koe1234/pentagon_2_666_le/(list of files, cad)

Other CAD files:
LE/PAE_MCU/utils/rom2c/Unit.obj
LE/PAE_MCU/utils/rom2c/compress.obj
