koe1234/pentagon_2_666_le/LE/PAE_MCU/make.txt

1. Скопировать образы ROM ZX-Spectrum и программы fatall в .\rom
2. Запустить все bat-файлы (если не надо менять прошивку rom/fpga, то соответствующий bat не запускать)
3. Открыть проект в keil uvision, выполнить "rebuild all target files"
4. Полученный pae_mcu.hex зашивать в контроллер.
