koe1234/pentagon_2_666_le/(threads)

Thread 1 (2024-10-18):

2.666 FE

NS-Clone, 2024-10-18:
Для моих аморальных проджоктов надо 100500 метров рамы
И пентевых хватит всем маловато будет
``2x8 Mb`` это 16мбит или 16 метров?
как ими рулить?
будет алоно 16с + банкоматная пол литра?

koe1234, 2024-10-21:
----------------
                        18.10.2024, 23:24, "NS-Clone" ***@***.***>:
                        Кому: koe1234/pentagon_2_666_le ***@***.***);
                        Копия: Subscribed ***@***.***);
                        Тема: [koe1234/pentagon_2_666_le] 2.666 FE (Issue #1);
                        16 метров. И с 16 битной шиной данных. 16с и вся банкоматная графика уже есть.
               
Для моих аморальных проджоктов надо 100500 метров рамы
И пентевых хватит всем маловато будет
2x8 Mb это 16мбит или 16 метров?
как ими рулить?
будет алоно 16с + банкоматная пол литра?

—Reply to this email directly, view it on GitHub, or unsubscribe.You are receiving this because you are subscribed to this thread.Message ID: ***@***.***>

NS-Clone, 2024-10-21:
> 16 метров.

ну тогда нада порты
они придуманы ужо?
16 метрами через один порт не порулишь
это или 2 порта на окно
возможно с защелкой старшего адреса
или же 2 бита нада вешать на адрес
и тогда можно будет щелкать сразу за один out
