koe1234/pentagon_2_666_le/LE/PAE_MCU/Firmwarez/usb/usbcfg.h

/*----------------------------------------------------------------------------
 *      U S B  -  K e r n e l
 *----------------------------------------------------------------------------
 *      Name:    USBCFG.H
 *      Purpose: USB Custom Configuration
 *      Version: V1.10
 *----------------------------------------------------------------------------
 *      This software is supplied "AS IS" without any warranties, express,
 *      implied or statutory, including but not limited to the implied
 *      warranties of fitness for purpose, satisfactory quality and
 *      noninfringement. Keil extends you a royalty-free right to reproduce
 *      and distribute executable files created using this software for use
 *      on Philips LPC microcontroller devices only. Nothing else gives you
 *      the right to use this software.
 *
 *      Copyright (c) 2005-2006 Keil Software.
 *---------------------------------------------------------------------------*/

#ifndef __USBCFG_H__
#define __USBCFG_H__

//*** <<< Use Configuration Wizard in Context Menu >>> ***

/*
// <h> USB Configuration
//   <o0> USB Power
//        <i> Default Power Setting
//        <0=> Bus-powered
//        <1=> Self-powered
//   <o1> Vendor ID <0x0000-0xFFFF>
//   <o2> Product ID <0x0000-0xFFFF>
//   <o3> Max Number of Interfaces <1-256>
//   <o4> Max Number of Endpoints  <1-32>
//   <o5> Max Endpoint 0 Packet Size
//        <8=> 8 Bytes <16=> 16 Bytes <32=> 32 Bytes <64=> 64 Bytes
//   <e6> DMA Transfer
//     <i> Use DMA for selected Endpoints
//     <o7.0>  Endpoint 0 Out
//     <o7.1>  Endpoint 0 In
//     <o7.2>  Endpoint 1 Out
//     <o7.3>  Endpoint 1 In
//     <o7.4>  Endpoint 2 Out
//     <o7.5>  Endpoint 2 In
//     <o7.6>  Endpoint 3 Out
//     <o7.7>  Endpoint 3 In
//     <o7.8>  Endpoint 4 Out
//     <o7.9>  Endpoint 4 In
//     <o7.10> Endpoint 5 Out
//     <o7.11> Endpoint 5 In
//     <o7.12> Endpoint 6 Out
//     <o7.13> Endpoint 6 In
//     <o7.14> Endpoint 7 Out
//     <o7.15> Endpoint 7 In
//     <o7.16> Endpoint 8 Out
//     <o7.17> Endpoint 8 In
//     <o7.18> Endpoint 9 Out
//     <o7.19> Endpoint 9 In
//     <o7.20> Endpoint 10 Out
//     <o7.21> Endpoint 10 In
//     <o7.22> Endpoint 11 Out
//     <o7.23> Endpoint 11 In
//     <o7.24> Endpoint 12 Out
//     <o7.25> Endpoint 12 In
//     <o7.26> Endpoint 13 Out
//     <o7.27> Endpoint 13 In
//     <o7.28> Endpoint 14 Out
//     <o7.29> Endpoint 14 In
//     <o7.30> Endpoint 15 Out
//     <o7.31> Endpoint 15 In
//   </e>
// </h>
*/

#define USB_POWER           1
#define USB_HID_VID         0x04CC
#define USB_HID_PID         0x1235
#define USB_IF_NUM          1
#define USB_EP_NUM          4
#define USB_MAX_PACKET0     64
#define USB_DMA             0
#define USB_DMA_EP          0x00000000


/*
// <h> USB Event Handlers
//   <h> Device Events
//     <o0.0> Power Event
//     <o1.0> Reset Event
//     <o2.0> Suspend Event
//     <o3.0> Resume Event
//     <o4.0> Remote Wakeup Event
//     <o5.0> Start of Frame Event
//     <o6.0> Error Event
//   </h>
//   <h> Endpoint Events
//     <o7.0>  Endpoint 0 Event
//     <o7.1>  Endpoint 1 Event
//     <o7.2>  Endpoint 2 Event
//     <o7.3>  Endpoint 3 Event
//     <o7.4>  Endpoint 4 Event
//     <o7.5>  Endpoint 5 Event
//     <o7.6>  Endpoint 6 Event
//     <o7.7>  Endpoint 7 Event
//     <o7.8>  Endpoint 8 Event
//     <o7.9>  Endpoint 9 Event
//     <o7.10> Endpoint 10 Event
//     <o7.11> Endpoint 11 Event
//     <o7.12> Endpoint 12 Event
//     <o7.13> Endpoint 13 Event
//     <o7.14> Endpoint 14 Event
//     <o7.15> Endpoint 15 Event
//   </h>
//   <h> USB Core Events
//     <o8.0>  Set Configuration Event
//     <o9.0>  Set Interface Event
//     <o10.0> Set/Clear Feature Event
//   </h>
// </h>
*/

#define USB_POWER_EVENT     0
#define USB_RESET_EVENT     1
#define USB_SUSPEND_EVENT   0
#define USB_RESUME_EVENT    0
#define USB_WAKEUP_EVENT    0
#define USB_SOF_EVENT       0
#define USB_ERROR_EVENT     0
#define USB_EP_EVENT        0x0003
#define USB_CONFIGURE_EVENT 1
#define USB_INTERFACE_EVENT 0
#define USB_FEATURE_EVENT   0

#define USB_CLASS           1
#define USB_HID             1

/*
// <h> Human Interface Device (HID) Configuration
//    <o0> Interface Number <0-255>
//    <o1> Report Bytes In <1-64>
//    <o2> In Report Polling Interval
//        <1=> 1 ms <2=> 2 ms <4=> 4 ms <8=> 8 ms <16=> 16 ms <32=> 32 ms
//    <o3> Report Bytes Out <1-64>
//    <o4> Out Report Polling Interval
//        <1=> 1 ms <2=> 2 ms <4=> 4 ms <8=> 8 ms <16=> 16 ms <32=> 32 ms
// </h>
*/




#define USB_HID_IF_NUM      0
#define USB_HID_REPORT_IN   32
#define USB_HID_IN_INTERVAL 1
#define USB_HID_REPORT_OUT  32
#define USB_HID_OUT_INTERVAL 1

#define USB_MSC             0
#define USB_MSC_IF_NUM      0
#define USB_AUDIO           0
#define USB_ADC_CIF_NUM     0
#define USB_ADC_SIF1_NUM    0
#define USB_ADC_SIF2_NUM    2


#endif  /* __USBCFG_H__ */
