koe1234/pentagon_2_666_le/LE/PAE_MCU/Firmwarez/DiskImg.c

/* Disk Image */

#include "type.h"
#include "memory.h"
#include "mscuser.h"

#include "sbl_iap.h"
#include "sbl_config.h"

const unsigned char BootSect[] = {
0xEB,0x3C,0x90,0x4D,0x53,0x44,0x4F,0x53,0x35,0x2E,0x30,0x00,0x02,BLOCKS_PER_CLUSTER,0x01,0x00,
0x01,0x10,0x00,0xEC,0x03,0xF8,0x02,0x00,0x01,0x00,0x01,0x00,0x00,0x00,
};

const unsigned char RootDirEntry[DIR_ENTRY] = {
 'C', 'R', 'P', ' ', 'D', 'I', 'S','A', 'B', 'L', 'D',0x28,0x00,0x00,0x00,0x00,
0x00,0x00,0x00,0x00,0x00,0x00,0x00,0x00,0x00,0x00,0x00,0x00,0x00,0x00,0x00,0x00,
 'P', 'E', 'N', 'T', 'A', 'G', 'O', 'N', 'B', 'I', 'N',0x20,0x18,0xbc,0x41,0x97,
0x37,0x38,0x37,0x38,0x00,0x00,0x3d,0x6e,0x2b,0x38,0x02,0x00,0x00,0xD0,0x07,0x00,
 };

const unsigned char CRPEntry[] = {' ', 'E', 'N', 'A','B', 'L', 'D',};
