koe1234/pentagon_2_666_le/LE/PAE_MCU/Firmwarez/sdcard/sd.h

/**************************************************************************//**
 * @file     sd.h
 * @brief    Header file for sd.c
 * @version  1.0
 * @date     18. Nov. 2010
 *
 * @note
 * Copyright (C) 2010 NXP Semiconductors(NXP), ChaN. 
 * All rights reserved.
 *
 ******************************************************************************/

#ifndef __SD_H
#define __SD_H

#include <LPC23xx.h>

/* type defintion */
typedef unsigned char    SD_BOOL;
#define SD_TRUE     1
#define SD_FALSE    0

#ifndef NULL
 #ifdef __cplusplus              // EC++
  #define NULL          0
 #else
  #define NULL          ((void *) 0)
 #endif
#endif

/* Memory card type definitions */
#define CARDTYPE_UNKNOWN        0
#define CARDTYPE_MMC            1   /* MMC */
#define CARDTYPE_SDV1           2   /* V1.x Standard Capacity SD card */
#define CARDTYPE_SDV2_SC        3   /* V2.0 or later Standard Capacity SD card */
#define CARDTYPE_SDV2_HC        4   /* V2.0 or later High/eXtended Capacity SD card */

/* SD/MMC card configuration */
typedef struct tagCARDCONFIG
{
    uint32_t sectorsize;    /* size (in byte) of each sector, fixed to 512bytes */
    uint32_t sectorcnt;     /* total sector number */  
    uint32_t blocksize;     /* erase block size in unit of sector */     
	uint8_t  ocr[4];		/* OCR */
	uint8_t  cid[16];		/* CID */
	uint8_t  csd[16];		/* CSD */
    uint8_t  status[64];    /* Status */
} CARDCONFIG;

/* Public variables */
extern uint8_t CardType;
extern CARDCONFIG CardConfig;


/* Public functions */
SD_BOOL     SD_Init (void);
SD_BOOL     SD_ReadSector (uint32_t sect, uint8_t *buf, uint32_t cnt);
SD_BOOL     SD_WriteSector (uint32_t sect, const uint8_t *buf, uint32_t cnt);
SD_BOOL     SD_ReadConfiguration (void);
uint8_t     SD_SendCommand (uint8_t cmd, uint32_t arg, uint8_t *buf, uint32_t len);
uint8_t     SD_SendACommand (uint8_t cmd, uint32_t arg, uint8_t *buf, uint32_t len);
SD_BOOL     SD_RecvDataBlock (uint8_t *buf, uint32_t len);
SD_BOOL     SD_SendDataBlock (const uint8_t *buf, uint8_t tkn, uint32_t len) ;
SD_BOOL     SD_WaitForReady (void);

#endif // __SD_H

/* --------------------------------- End Of File ------------------------------ */
