koe1234/pentagon_2_666_le/(commit log)

2025-01-26 Update pae_mcu.c
    ps/2 interface fix
    [pae_mcu.c]
2025-04-20 Delete mcu directory
    delete before update
    [Unit.obj, compress.obj]
2025-04-20 Add files via upload
    added new files
    [Unit.obj, compress.obj]
